ryanbagwell/talking-halloween-toilet/burping_toilet/burp.h

const unsigned char burp_wav[] = {
  0x52, 0x49, 0x46, 0x46, 0x9e, 0xb9, 0x00, 0x00, 0x57, 0x41, 0x56, 0x45,
  0x66, 0x6d, 0x74, 0x20, 0x10, 0x00, 0x00, 0x00, 0x01, 0x00, 0x01, 0x00,
  0x80, 0x3e, 0x00, 0x00, 0x00, 0x7d, 0x00, 0x00, 0x02, 0x00, 0x10, 0x00,
  0x64, 0x61, 0x74, 0x61, 0x7a, 0xb9, 0x00, 0x00, 0x00, 0x00, 0x00, 0x00,
  0x00, 0x00, 0x00, 0x00, 0x00, 0x00, 0x00, 0x00, 0x00, 0x00, 0x00, 0x00,
  0x00, 0x00, 0x00, 0x00, 0x00, 0x00, 0x00, 0x00, 0x00, 0x00, 0x00, 0x00,
  0x00, 0x00, 0x00, 0x00, 0x00, 0x00, 0x00, 0x00, 0x00, 0x00, 0x00, 0x00,
  0x00, 0x00, 0x00, 0x00, 0x00, 0x00, 0x00, 0x00, 0x00, 0x00, 0x00, 0x00,
  0x00, 0x00, 0x00, 0x00, 0x00, 0x00, 0x00, 0x00, 0x00, 0x00, 0x00, 0x00,
  0x00, 0x00, 0x00, 0x00, 0x00, 0x00, 0x00, 0x00, 0x00, 0x00, 0x00, 0x00,
  0x00, 0x00, 0x00, 0x00, 0x00, 0x00, 0x00, 0x00, 0x00, 0x00, 0x00, 0x00,
  0x00, 0x00, 0x00, 0x00, 0x00, 0x00, 0x00, 0x00, 0x00, 0x00, 0x00, 0x00,
  0x00, 0x00, 0x00, 0x00, 0x00, 0x00, 0x00, 0x00, 0x00, 0x00, 0x00, 0x00,
  0x00, 0x00, 0x00, 0x00, 0x00, 0x00, 0x00, 0x00, 0x00, 0x00, 0x00, 0x00,
  0x00, 0x00, 0x00, 0x00, 0x00, 0x00, 0x00, 0x00, 0x00, 0x00, 0x00, 0x00,
  0x00, 0x00, 0x00, 0x00, 0x00, 0x00, 0x00, 0x00, 0x00, 0x00, 0x00, 0x00,
  0x00, 0x00, 0x00, 0x00, 0x00, 0x00, 0x00, 0x00, 0x00, 0x00, 0x28, 0xff,
  0xdc, 0xff, 0x24, 0x00, 0x30, 0x00, 0x0c, 0x00, 0xc4, 0xff, 0xdc, 0xff,
  0x54, 0x00, 0x18, 0x00, 0x88, 0xff, 0xe8, 0xff, 0xe8, 0xff, 0x54, 0x00,
  0x78, 0x00, 0x48, 0x00, 0x24, 0x00, 0x00, 0x00, 0x00, 0x00, 0xac, 0xff,
  0x24, 0x00, 0x6c, 0x00, 0xb8, 0xff, 0xc4, 0xff, 0xc4, 0xff, 0xb8, 0xff,
  0x0c, 0x00, 0xc4, 0xff, 0xdc, 0xff, 0xe8, 0xff, 0x00, 0x00, 0x24, 0x00,
  0x0c, 0x00, 0xa0, 0xff, 0xf4, 0xff, 0x18, 0x00, 0x00, 0x00, 0xf4, 0xff,
  0xe8, 0xff, 0x00, 0x00, 0xdc, 0xff, 0xdc, 0xff, 0xb8, 0xff, 0x1c, 0xff,
  0x7c, 0xff, 0xa0, 0xff, 0xc4, 0xff, 0xc4, 0xff, 0x58, 0xff, 0x7c, 0xff,
  0xb8, 0xff, 0xac, 0xff, 0xe8, 0xff, 0xdc, 0xff, 0xdc, 0xff, 0x70, 0xff,
  0x70, 0xff, 0x00, 0x00, 0xc4, 0xff, 0xb8, 0xff, 0x94, 0xff, 0xe8, 0xff,
  0xb8, 0xff, 0x88, 0xff, 0x30, 0x00, 0xdc, 0xff, 0x58, 0xff, 0x94, 0xff,
  0xac, 0xff, 0x18, 0x00, 0x24, 0x00, 0x18, 0x00, 0x0c, 0x00, 0x18, 0x00,
  0x0c, 0x00, 0xe8, 0xff, 0x3c, 0x00, 0x30, 0x00, 0xe8, 0xff, 0x0c, 0x00,
  0x00, 0x00, 0x7c, 0xff, 0x0c, 0x00, 0x60, 0x00, 0x18, 0x00, 0xe8, 0xff,
  0x48, 0x00, 0xa8, 0x00, 0x24, 0x00, 0x78, 0x00, 0x9c, 0x00, 0x54, 0x00,
  0x30, 0x00, 0x84, 0x00, 0xd8, 0x00, 0x30, 0x00, 0x60, 0x00, 0x6c, 0x00,
  0x3c, 0x00, 0x84, 0x00, 0x78, 0x00, 0x00, 0x00, 0x48, 0x00, 0x00, 0x00,
  0x3c, 0x00, 0x24, 0x00, 0xc4, 0xff, 0x48, 0x00, 0x18, 0x00, 0x6c, 0x00,
  0x90, 0x00, 0xb4, 0x00, 0xa8, 0x00, 0x9c, 0x00, 0x54, 0x00, 0xa8, 0x00,
  0x78, 0x00, 0x48, 0x00, 0x48, 0x00, 0xa8, 0x00, 0xc0, 0x00, 0xb4, 0x00,
  0x84, 0x00, 0x30, 0x00, 0xd8, 0x00, 0x90, 0x00, 0x78, 0x00, 0xa8, 0x00,
  0x90, 0x00, 0x08, 0x01, 0xd8, 0x00, 0xc0, 0x00, 0x3c, 0x00, 0xf4, 0xff,
  0x30, 0x00, 0xf4, 0xff, 0x9c, 0x00, 0x9c, 0x00, 0xb4, 0x00, 0x30, 0x00,
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
};
unsigned int burp_wav_len = 47526;
